AryanRai/mech5720-2026-event-scanner/report/figures/nd_APS_pair.pdf

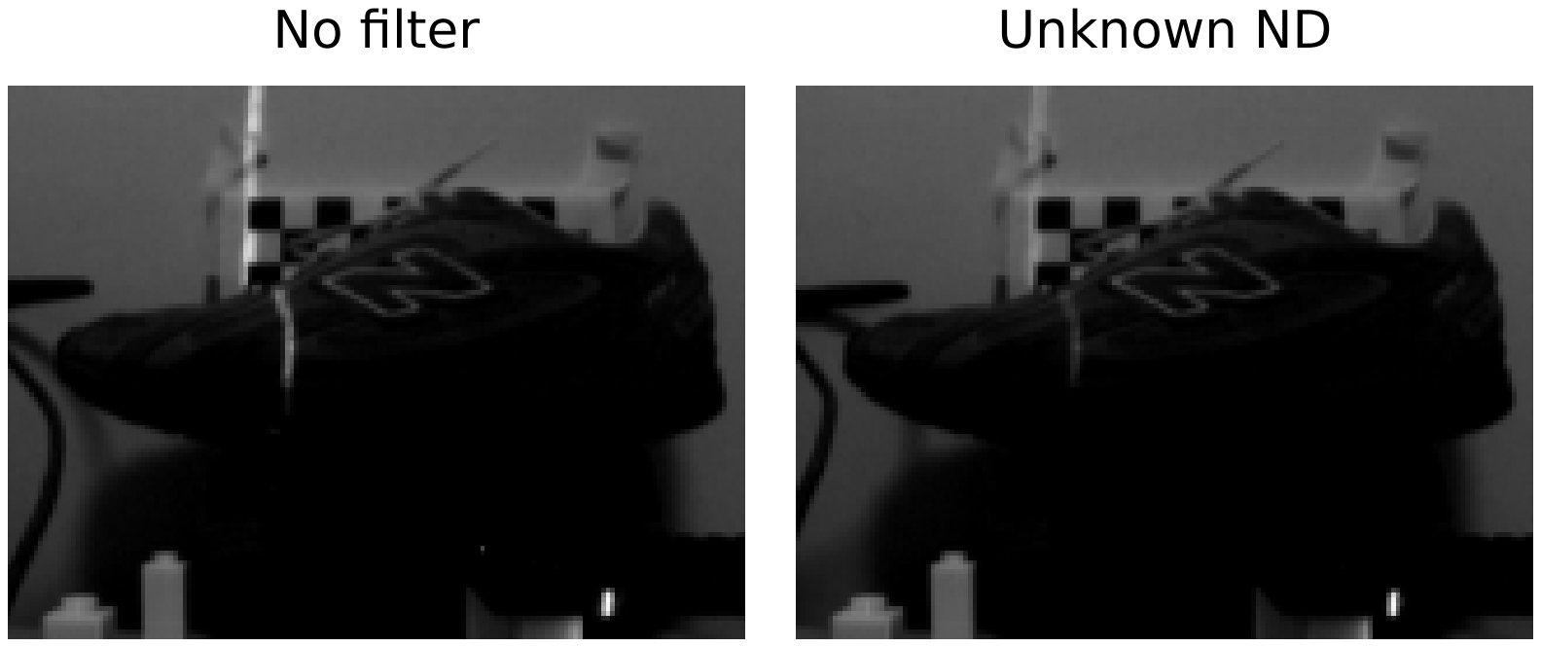
[picture p32: page 1]

No filter | Unknown ND
