AryanRai/mech5720-2026-event-scanner/report/figures/triangulation_compact.pdf

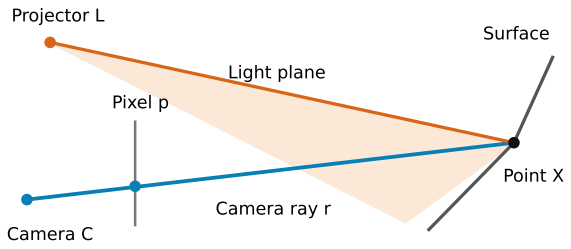
[picture p33: figure]
Camera C; Projector L; Pixel p; Camera ray r; Light plane; Point X; Surface
