AryanRai/mech5720-2026-event-scanner/output/pdf/checkerboard_9x6_A4.pdf

9 x 6 inner corners | 10 x 7 squares | square size: 18 mm
Print on A4 at 100% / actual size. Measure a square after printing.
