AryanRai/mech5720-2026-event-scanner/docs/images/aps_cloud.png

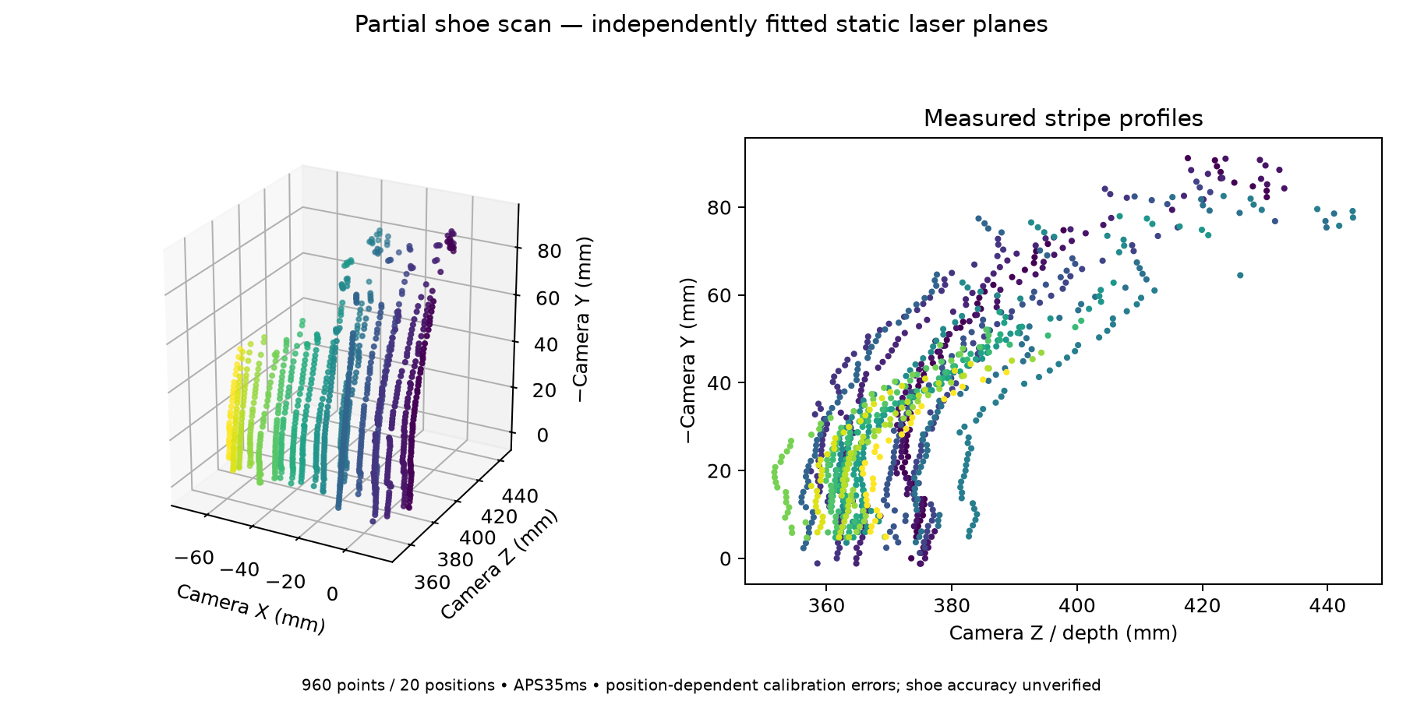
docs/images/aps_cloud.png
