AryanRai/mech5720-2026-event-scanner/examples/coverage/repro_data/shoe_photo.png

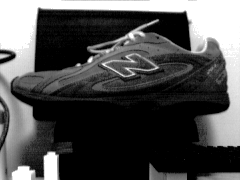
examples/coverage/repro_data/shoe_photo.png
