AryanRai/mech5720-2026-event-scanner/outputs/analysis/hardware_sanity_02/diagnostics.png

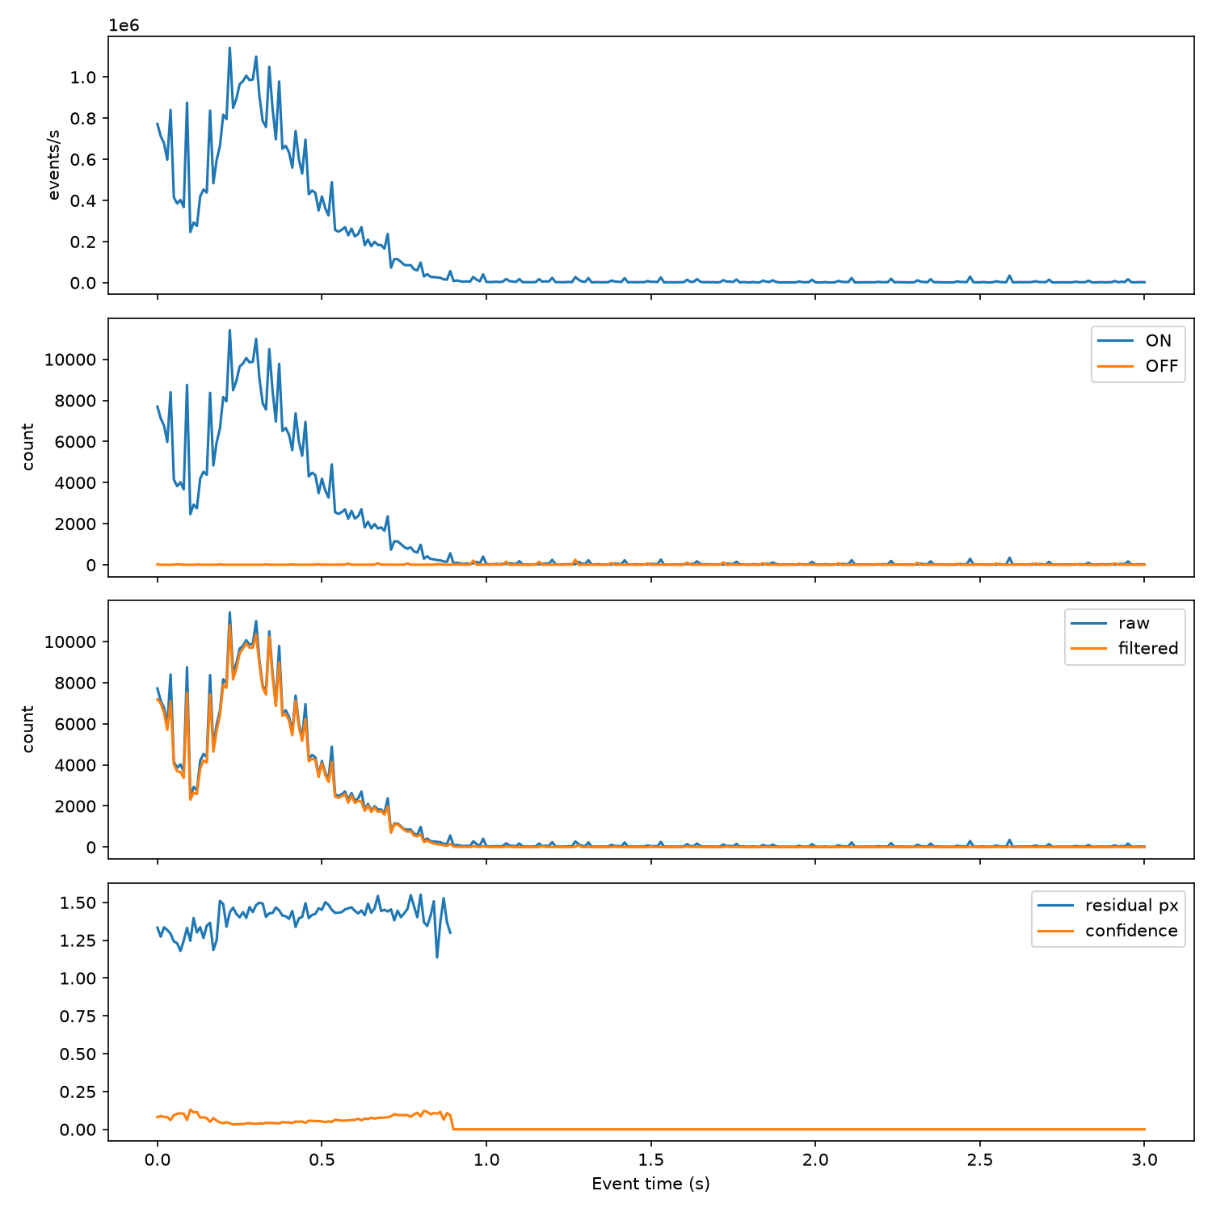
outputs/analysis/hardware_sanity_02/diagnostics.png
