AryanRai/mech5720-2026-event-scanner/outputs/current_aps.png

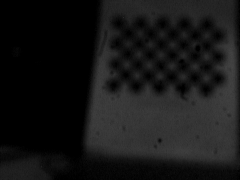
outputs/current_aps.png
