AryanRai/mech5720-2026-event-scanner/outputs/lens_diagnostic/exposure_80ms.png

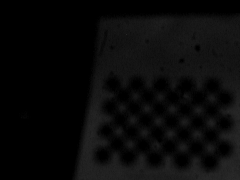
outputs/lens_diagnostic/exposure_80ms.png
