AryanRai/mech5720-2026-event-scanner/report/figures/board_comparison.png

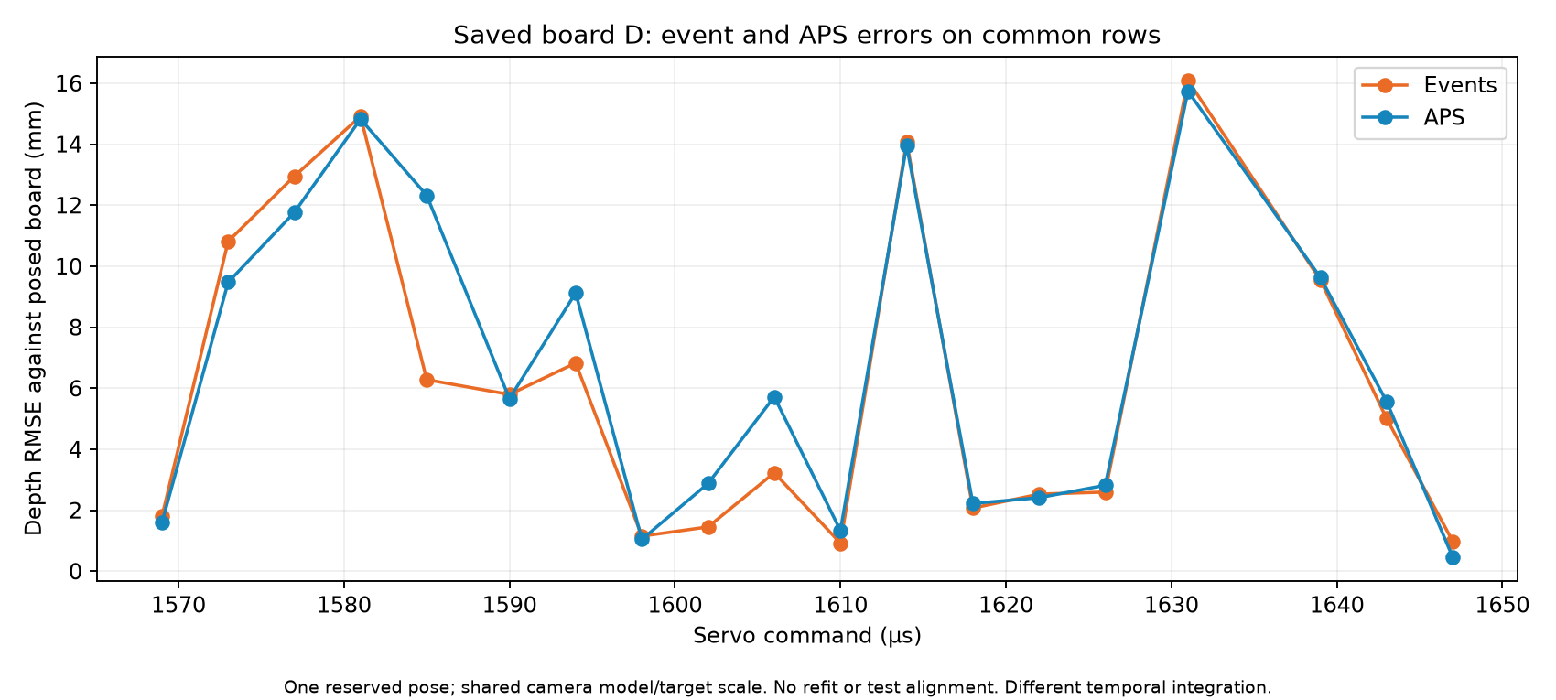
report/figures/board_comparison.png
