AryanRai/mech5720-2026-event-scanner/report/figures/dashboard.jpg

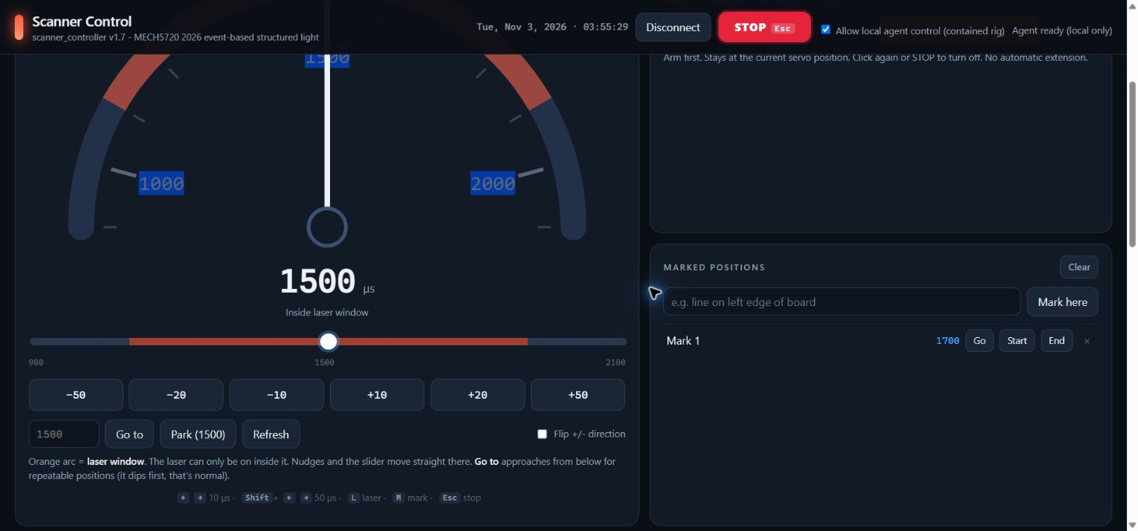
report/figures/dashboard.jpg
