AryanRai/mech5720-2026-event-scanner/report/figures/intrinsic_refinement.png

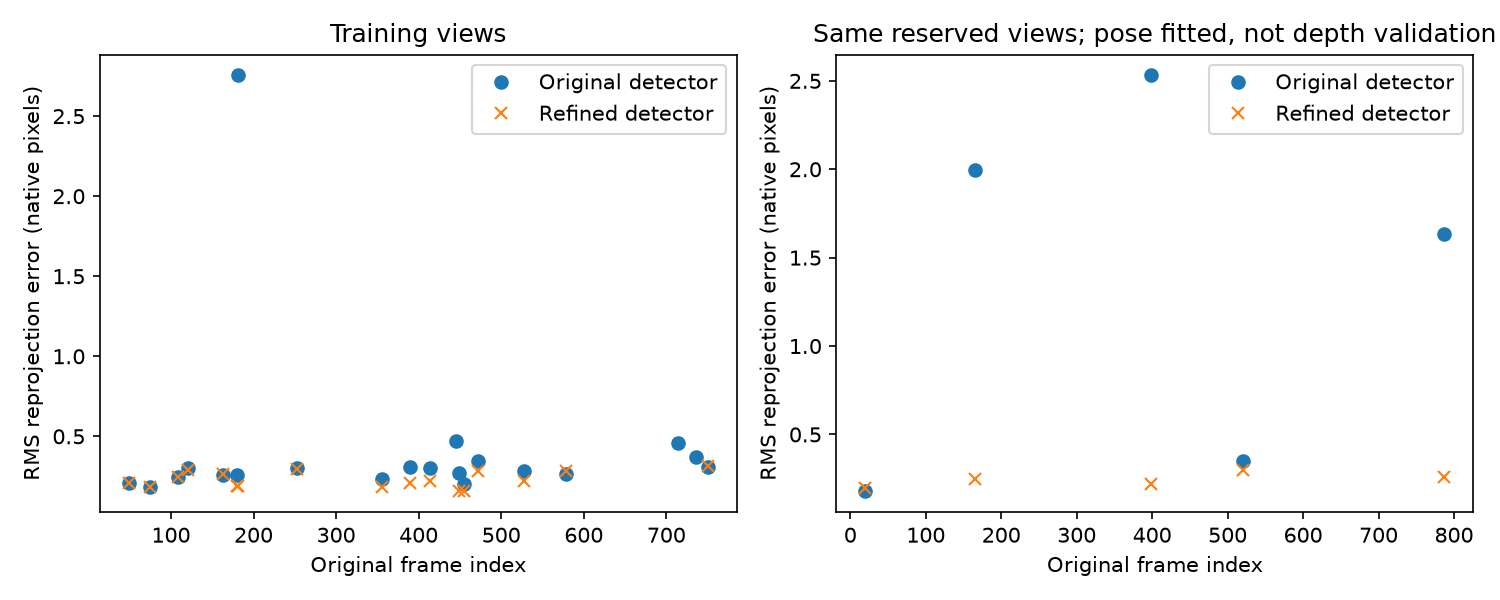
report/figures/intrinsic_refinement.png
