AryanRai/mech5720-2026-event-scanner/report/figures/nd_comparison.png

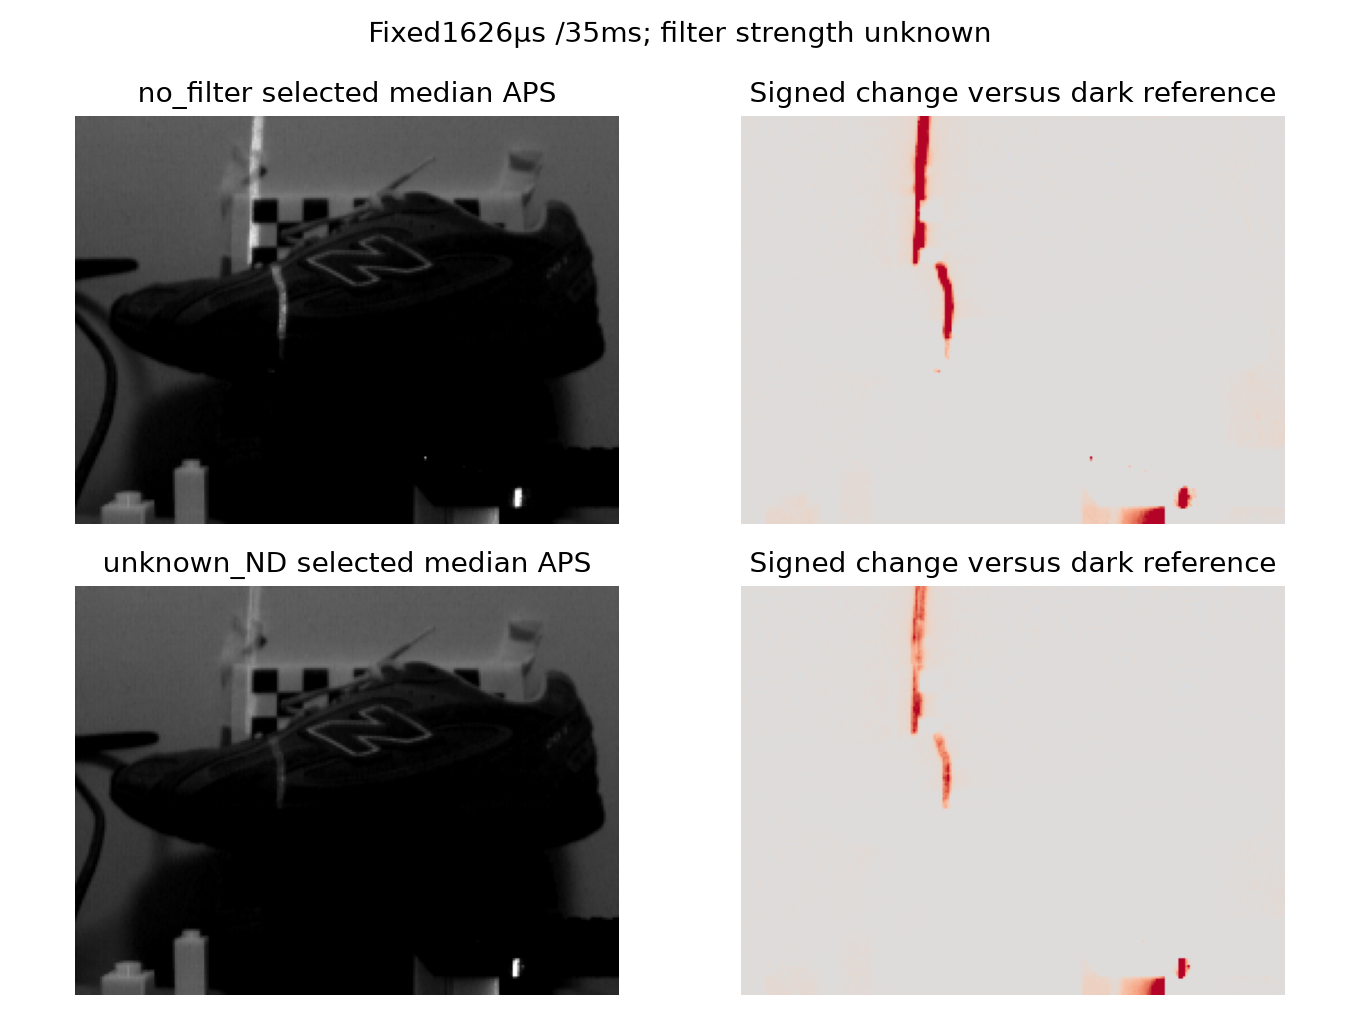
report/figures/nd_comparison.png
