AryanRai/mech5720-2026-event-scanner/report/figures/real_stripe_photo.jpg

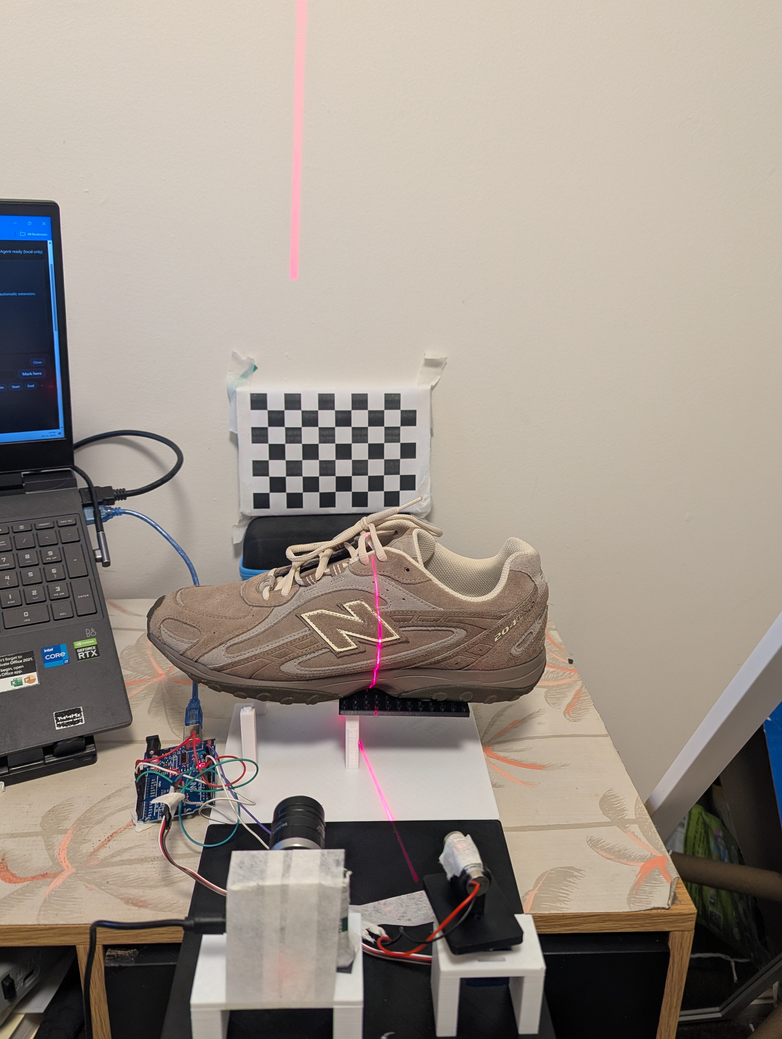
report/figures/real_stripe_photo.jpg
