AryanRai/mech5720-2026-event-scanner/report/figures/repeatability.png

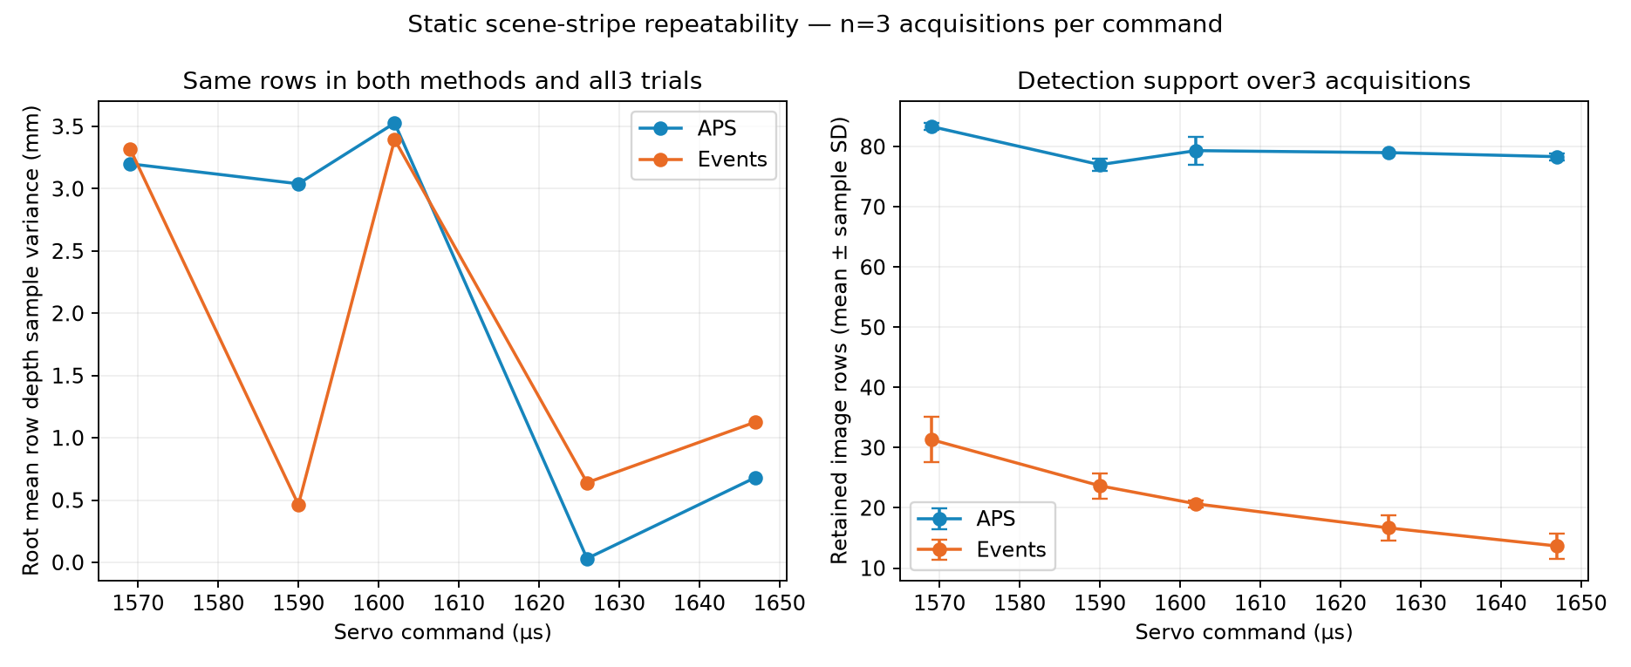
report/figures/repeatability.png
