AryanRai/mech5720-2026-event-scanner/report/figures/timing.png

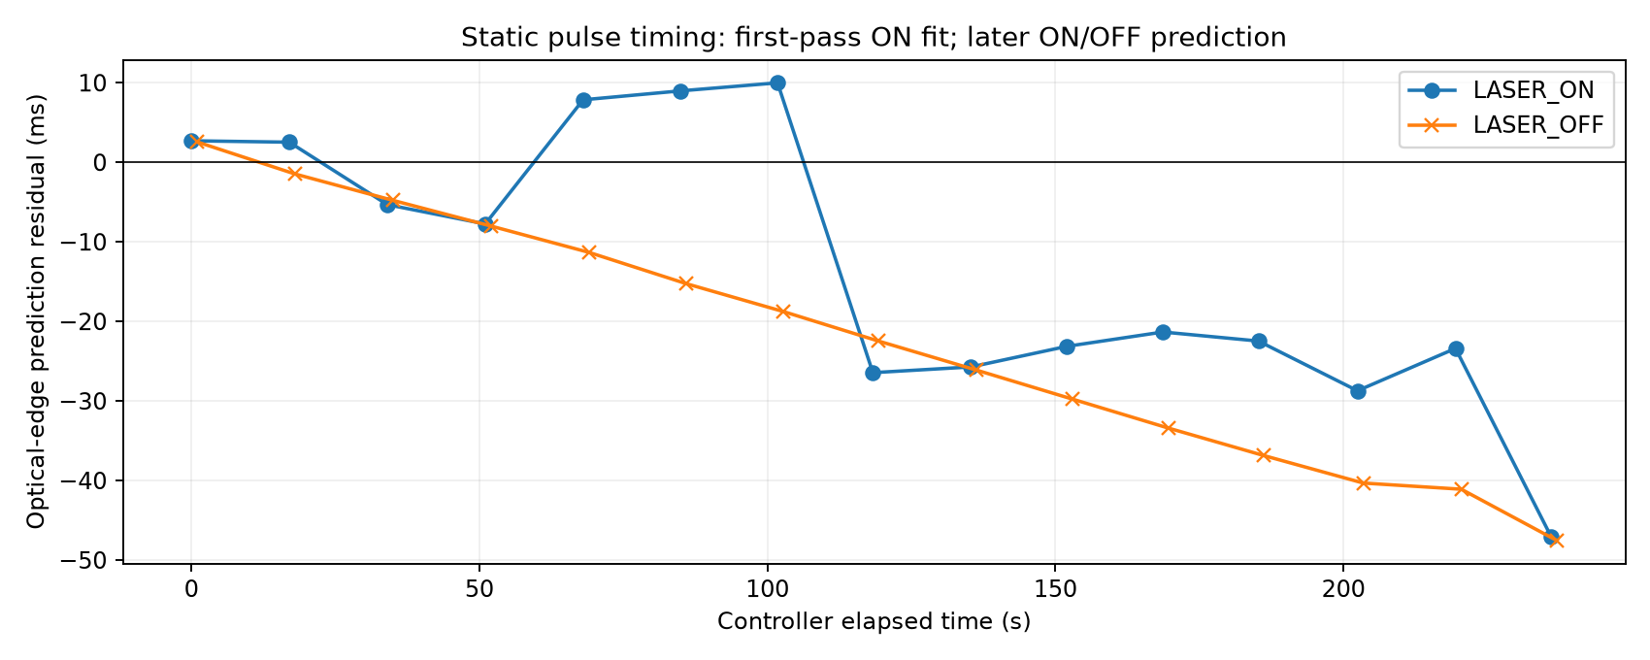
report/figures/timing.png
