AryanRai/mech5720-2026-event-scanner/report/figures/triangulation_schematic.png

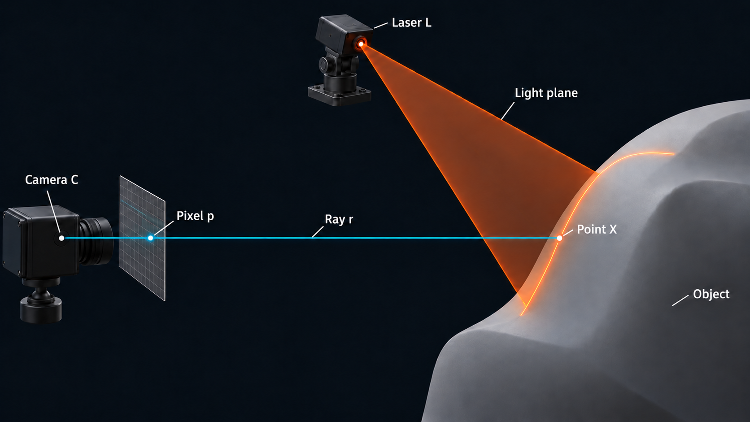
report/figures/triangulation_schematic.png
