AryanRai/mech5720-2026-event-scanner/hardware/cad_review/DAVIS240C_Scanner_Review.step

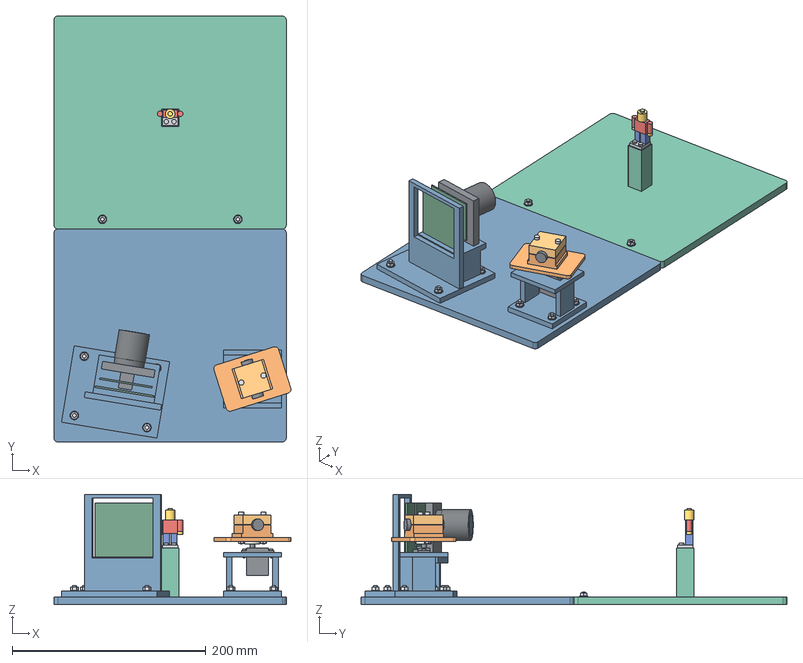
[picture p48: CAD file, 2026-11-07]
hardware/cad_review/DAVIS240C_Scanner_Review.step
244.9 x 440.0 x 114.0 mm
01_Solid_Base
02_DAVIS_Upright_Bracket
03_Servo_Bracket
REF_Servo_Provisional
REF_Servo_Horn_Provisional
04_Rotating_Laser_Cradle
05_Laser_Clamp_Lower
06_Laser_Clamp_Upper
REF_Laser_Provisional
REF_Laser_Aperture
REF_DAVIS240C_Housing_Simplified
REF_DAVIS240C_Boards_Simplified
REF_Lens_Envelope_TBC
REF_Lens_Front_Glass
07_Object_Base_With_Studded_Pedestal
REF_Real_LEGO_Plate_Approximate
REF_Minifigure_Legs_Approximate
REF_Minifigure_Torso_Approximate
REF_Minifigure_Head_Hands_Approximate
REF_Base_Fixing_01
REF_Base_Fixing_02
REF_Base_Fixing_03
REF_Base_Fixing_04
REF_Base_Fixing_05
REF_Base_Fixing_06
REF_Base_Fixing_07
REF_Base_Fixing_08
REF_Camera_Quarter_Inch_Screw_TBC
REF_Joining_M4_Fixing_1
REF_Joining_M4_Fixing_2
REF_Servo_Ear_Screw_01_TBC
REF_Servo_Ear_Screw_02_TBC
REF_Clamp_M3_Fixing_01
REF_Clamp_M3_Fixing_02
REF_Horn_to_Cradle_Screw_01_TBC
REF_Horn_to_Cradle_Screw_02_TBC
REF_Horn_Centre_Screw_TBC
