AryanRai/mech5720-2026-event-scanner/report/figures/scanner_wiring.png

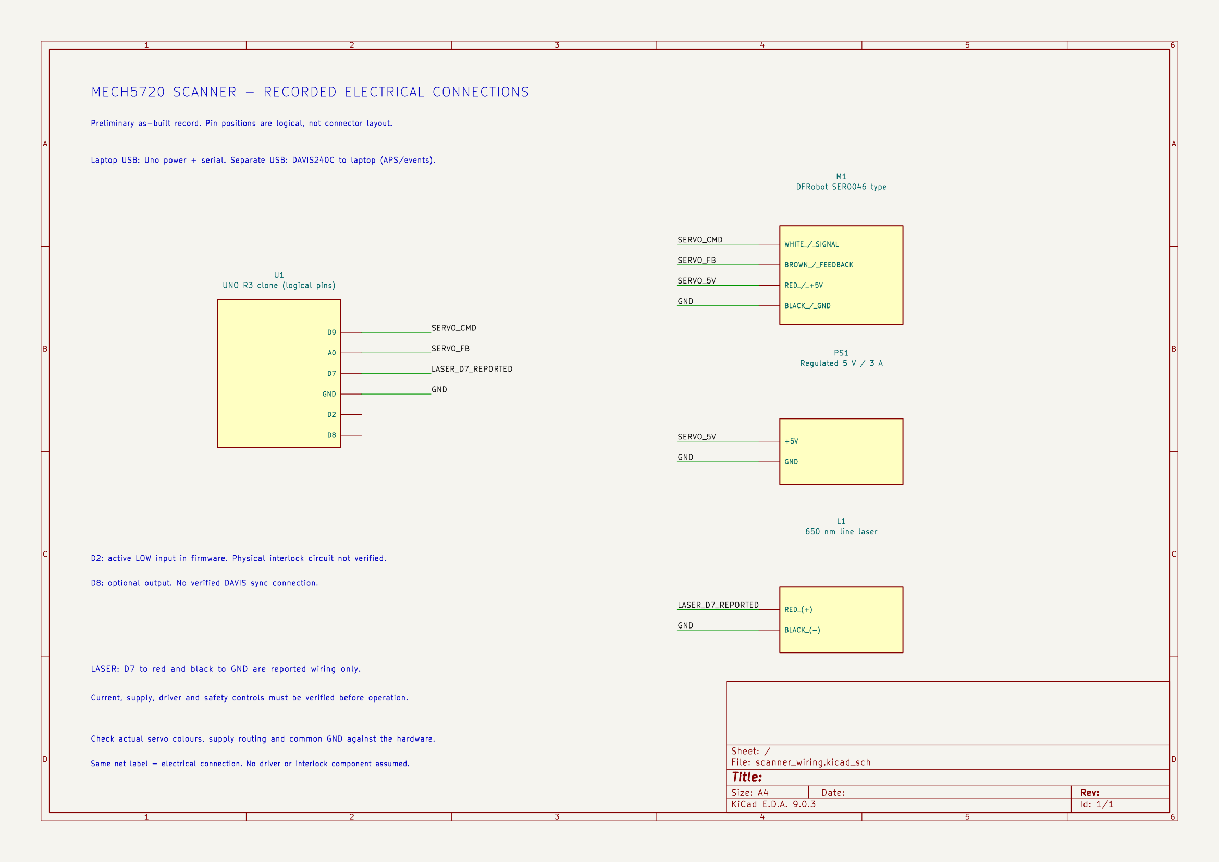
report/figures/scanner_wiring.png
