AryanRai/mech5720-2026-event-scanner/results/platform_audit/REVIEW.md

# Earlier four-hole-mount platform audit — 8 November 2026

User identifies these earlier captures as the original four-hole mounting, before the subsequent leftward remount. This audit uses the older recordings and their original frozen ABDE2 calibration, not the later dense ABC fit. No hardware operation or new capture occurred.

Examined original sparse scan: five retained source recordings at 1569, 1602, 1618, 1634 and 1651 us (the original 1520 observation had no retained valid source observation in the reconstruction manifest and is not silently counted). Original denser preview: four independently fitted calibration knots, excluding interpolated-plane commands. Also examined the early 20-position independently fitted scan. All raw paths/hashes and frame selections are in the respective summary.json files.

The original sparse scan yields 102 lower-row image-change candidates (23/20/19/27/13 at the five commands), including more coherent vertical segments below the shoe. The original denser preview's four fitted knots yield 84; the early calibrated twenty-position dataset yields 140. These are post-hoc lower-image candidates, not confirmed platform detections or coverage numerators. Bright spots/supports may also qualify. No hand-labelled stripe ground truth was created. The original shoe reconstruction was not modified.

The illustrated lower-image region is rows 120..179, extending the prior row-group screen with delta>20 and intensity>40, maximum width12, ambiguity rejection, clipping rejection and repeated-frame support. Optical peaks are searched within 2..6 seconds and the connected half-peak interval is retained. Candidate coordinates and unvalidated ray/plane intersections are saved separately. Camera timestamp selection is not physical synchronisation. Earlier sparse frames use different exposure from later captures; this is not a controlled density comparison.

Four-hole mounting removes the specific leftward-remount ambiguity for this condition, but does not independently measure the camera-to-CAD transform. Current CAD contains nominal component envelopes, provisional interfaces and an approximate LEGO plate. Actual optical pose changed during the project. A complete metric reference face requires identified CAD-to-image feature correspondences and a justified pose, visible boundaries and tolerance. Fitting those to the same recovered platform points and measuring their residuals would be self-consistency, not independent completeness/accuracy.

Conclusion: older data has more useful candidate platform traces than the latest five-line demonstration. It is the correct historical condition to investigate, but an independently anchored expected metric surface is still missing. Do not mark physical completeness complete or report a percentage from these candidate counts. The published image-space shoe coverage is unchanged. A clearly identifiable retained setup image/measurement establishing the actual mounted face and pose could permit further analysis without another scan; nominal assembly placement alone is insufficient.

Figure: platform_audit.png; numerical candidates: lower_candidates.csv; raw hashes/frame selections/model hash: summary.json. The script can be rerun with --dataset original_sparse / original_dense / early_calibrated and a new --output directory. Initial version01 contact sheets contained unused axes; version02 fixes only the displayed command layout. The candidate values are unchanged.

The report now records the 102 candidates as an exploratory reuse audit, explicitly not a physical-completeness result. Newer wiring illustrations/photographs present in the live Overleaf source were preserved; their repository image copies were extracted from the downloaded compiled PDF, not independently obtained or newly measured. The full schematic remains in report/figures/scanner_wiring.png.
