AryanRai/mech5720-2026-event-scanner/results/platform_audit/lower_candidates.csv

command_us | pixel_x | pixel_y | support_frames | X_mm | Y_mm | Z_mm | positive_finite_depth
1569 | 221.2140350877193 | 124.0 | 21.0 | 55.231525802844445 | 10.404348803886734 | 156.37146965776742 | True
1569 | 221.0 | 125.0 | 21.0 | 55.17555708489025 | 10.939747271831346 | 156.53621707822396 | True
1569 | 220.65758754863813 | 127.0 | 21.0 | 55.080500902963024 | 12.007607750725926 | 156.77934835752401 | True
1569 | 220.36206896551724 | 128.0 | 21.0 | 55.00833342058555 | 12.552234248978744 | 157.02548506498 | True
1569 | 220.0 | 129.0 | 21.0 | 54.922776214906065 | 13.103809357394788 | 157.33905436974553 | True
1569 | 219.79918032786884 | 130.0 | 21.0 | 54.86924993342831 | 13.644138207214219 | 157.4900677574152 | True
1569 | 219.29655172413794 | 131.0 | 21.0 | 54.75512828580319 | 14.211558019529866 | 157.9472555601582 | True
1569 | 219.0 | 132.0 | 20.0 | 54.6821182933906 | 14.763586149192491 | 158.1960244077463 | True
1569 | 218.0 | 133.0 | 21.0 | 54.465915743346514 | 15.383285389715333 | 159.16746738921142 | True
1569 | 217.0 | 134.0 | 21.0 | 54.247352450474395 | 16.01021807291764 | 160.14940969231918 | True
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
