AryanRai/mech5720-2026-event-scanner/data/calibration/intrinsics/images/image_20261030_163826_587536.png

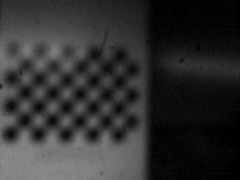
data/calibration/intrinsics/images/image_20261030_163826_587536.png
