AryanRai/mech5720-2026-event-scanner/data/calibration/intrinsics/images/image_20261030_164251_771076.png

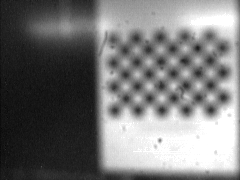
data/calibration/intrinsics/images/image_20261030_164251_771076.png
