AryanRai/mech5720-2026-event-scanner/data/calibration/intrinsics/images/image_20261030_165030_823524.png

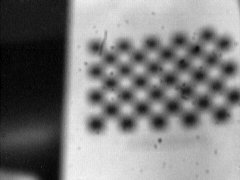
data/calibration/intrinsics/images/image_20261030_165030_823524.png
