AryanRai/mech5720-2026-event-scanner/outputs/calibration_inspect.png

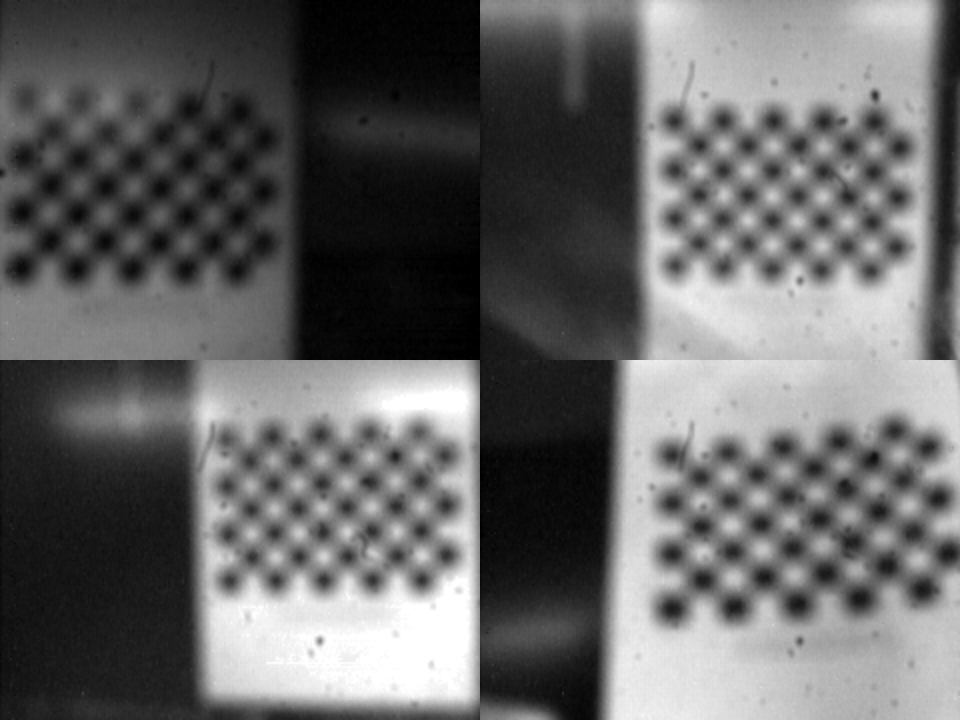
outputs/calibration_inspect.png
