AryanRai/mech5720-2026-event-scanner/results/platform_audit/platform_audit.png

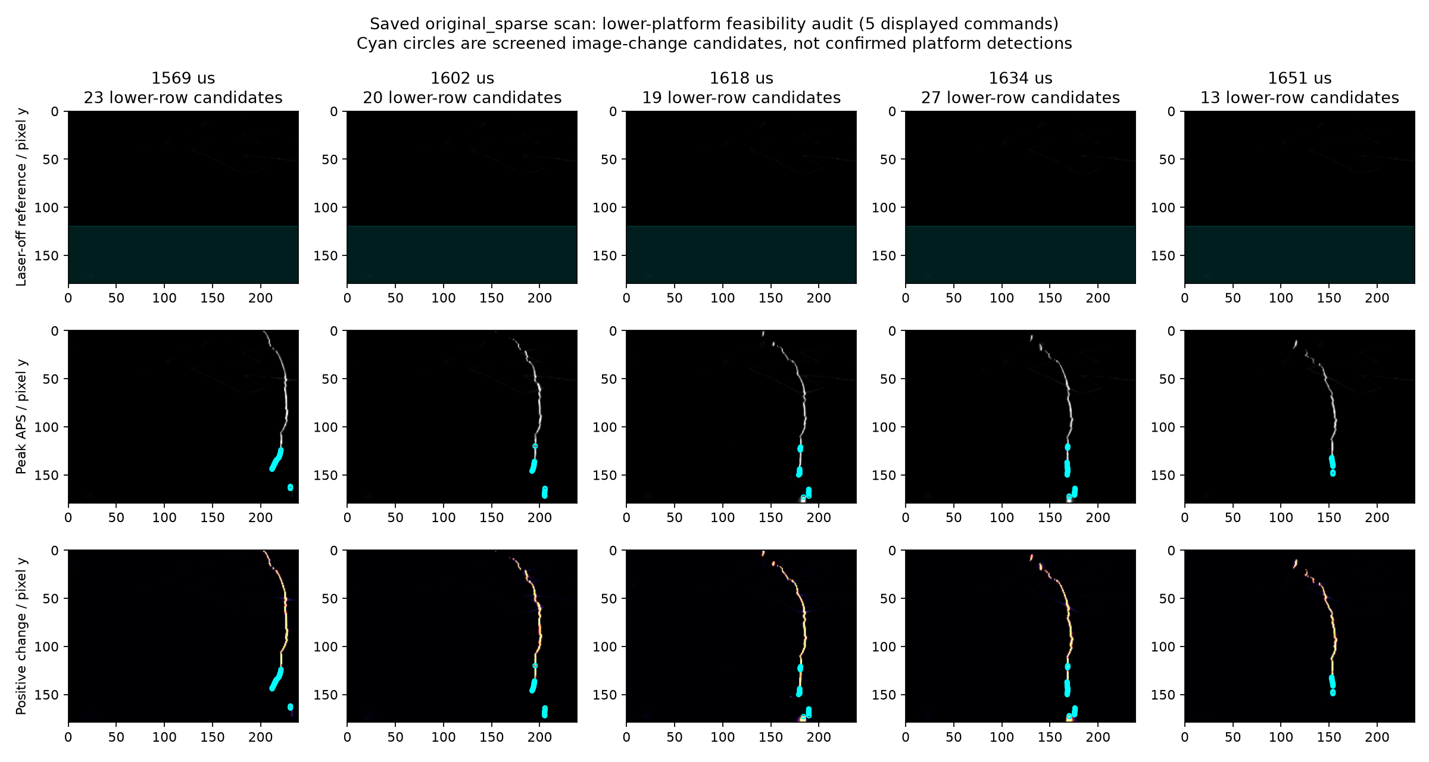
results/platform_audit/platform_audit.png
