AryanRai/mech5720-2026-event-scanner/report/figures/intrinsic_refinement_compact.pdf

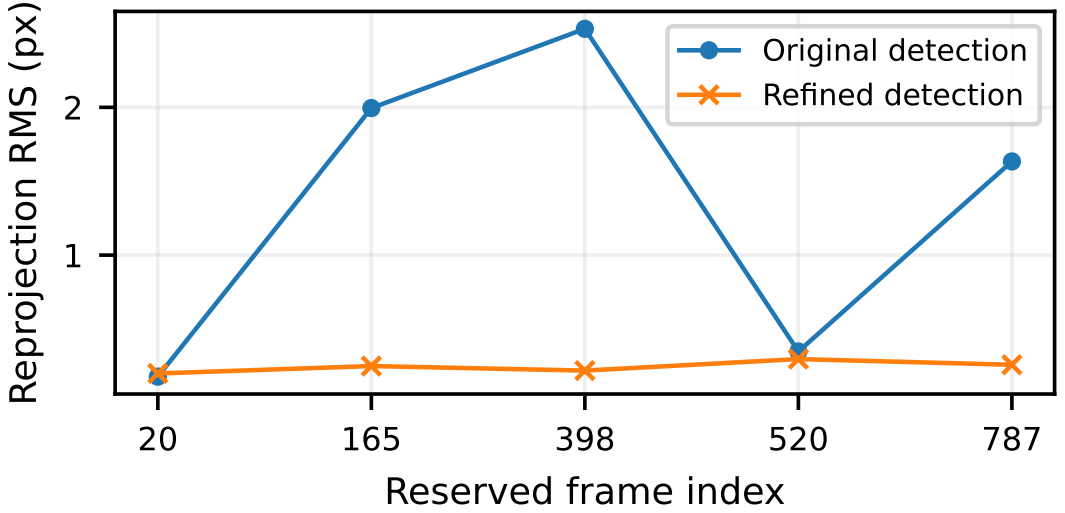
[picture p56: page 1]
Original detection Re; fined detection

Reprojection RMS (px)

Reserved frame index
