AryanRai/mech5720-2026-event-scanner/report/figures/board_compact.pdf

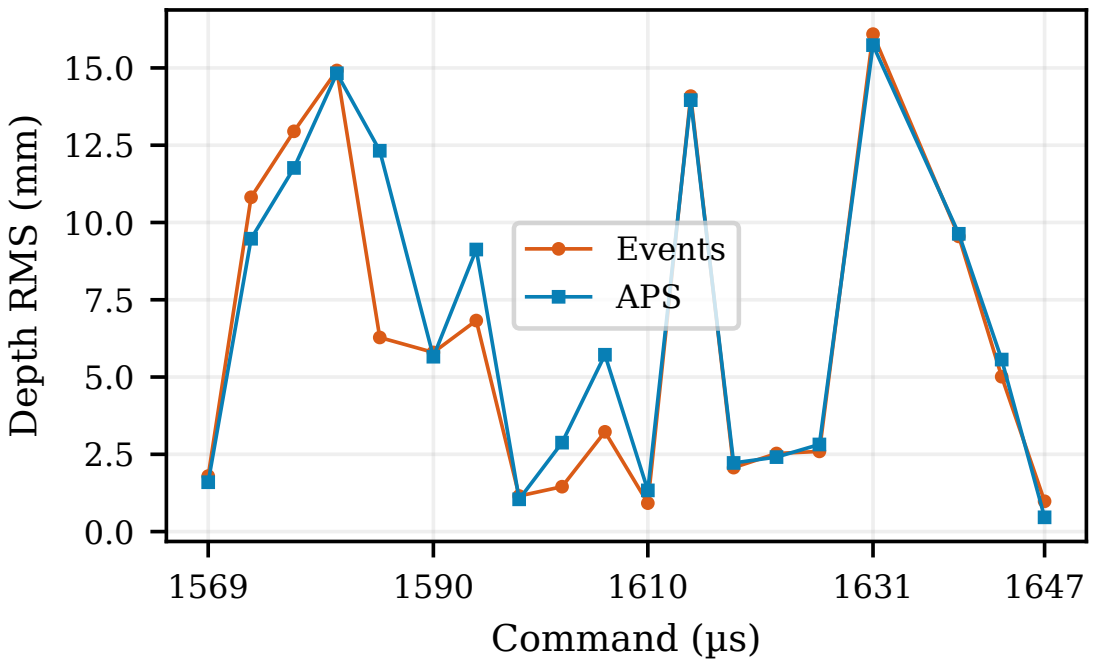
[picture p57: page 1]
Command (µs); Events APS

Depth RMS (mm)
