AryanRai/mech5720-2026-event-scanner/report/figures/coverage_compact.pdf

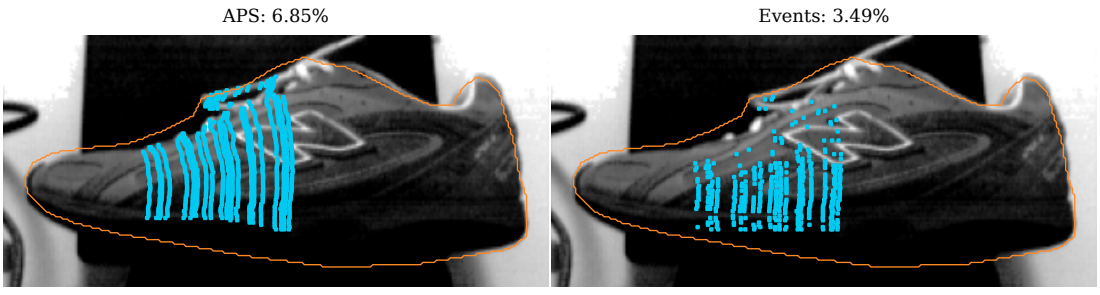
[picture p58: page 1]
APS: 6.85%; Events: 3.49%
