AryanRai/mech5720-2026-event-scanner/report/figures/paired_clouds.pdf

## APS: 960 points

## Static events: 494 points

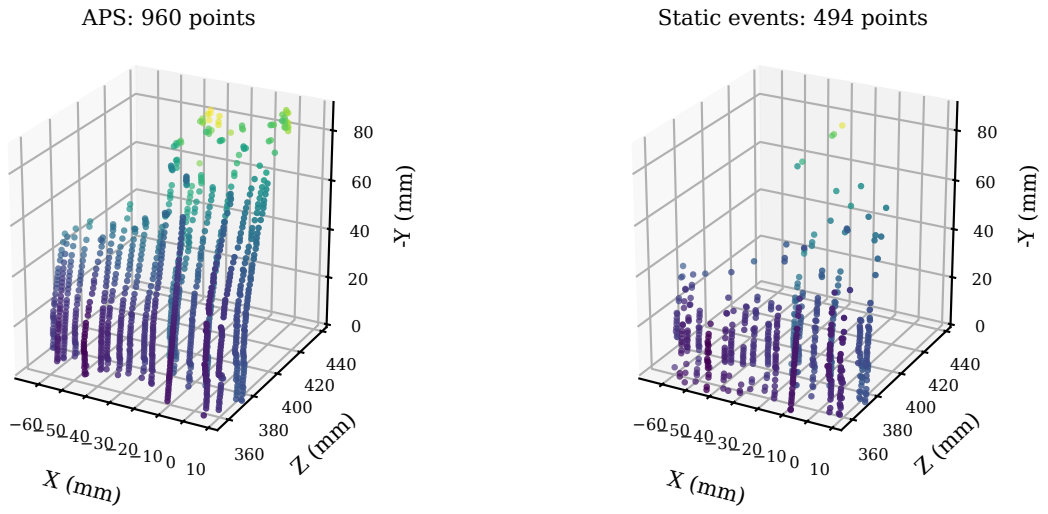
[picture p59: page 1]
