AryanRai/mech5720-2026-event-scanner/report/figures/repeat_compact.pdf

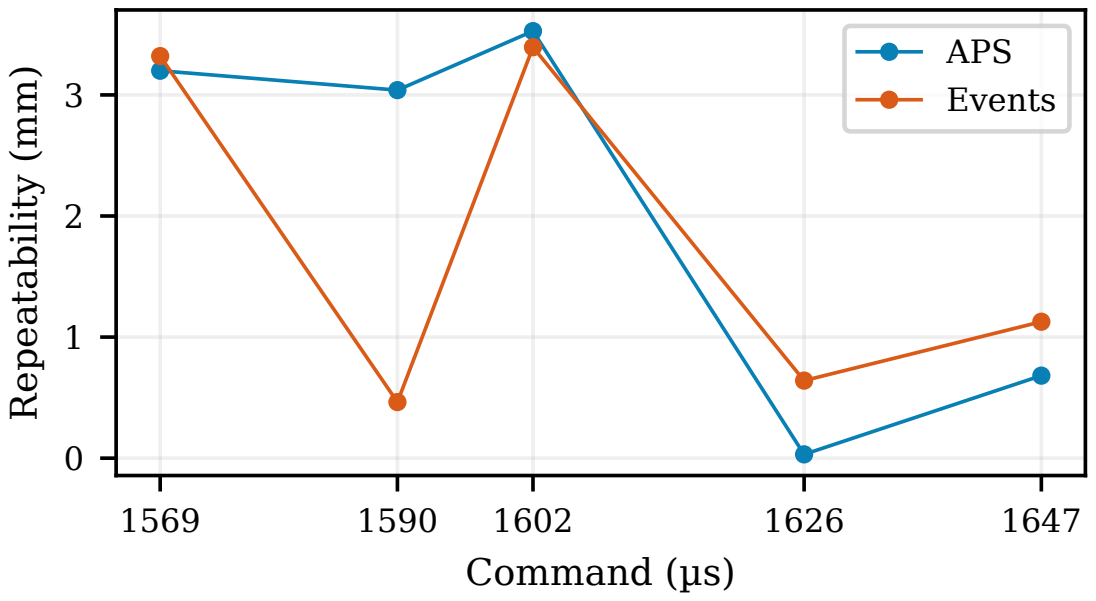
[picture p60: page 1]
Command (µs); Repeatability (mm); APS Events
