AryanRai/mech5720-2026-event-scanner/report/figures/timing_compact.pdf

−50 −40 −30 −20 −100

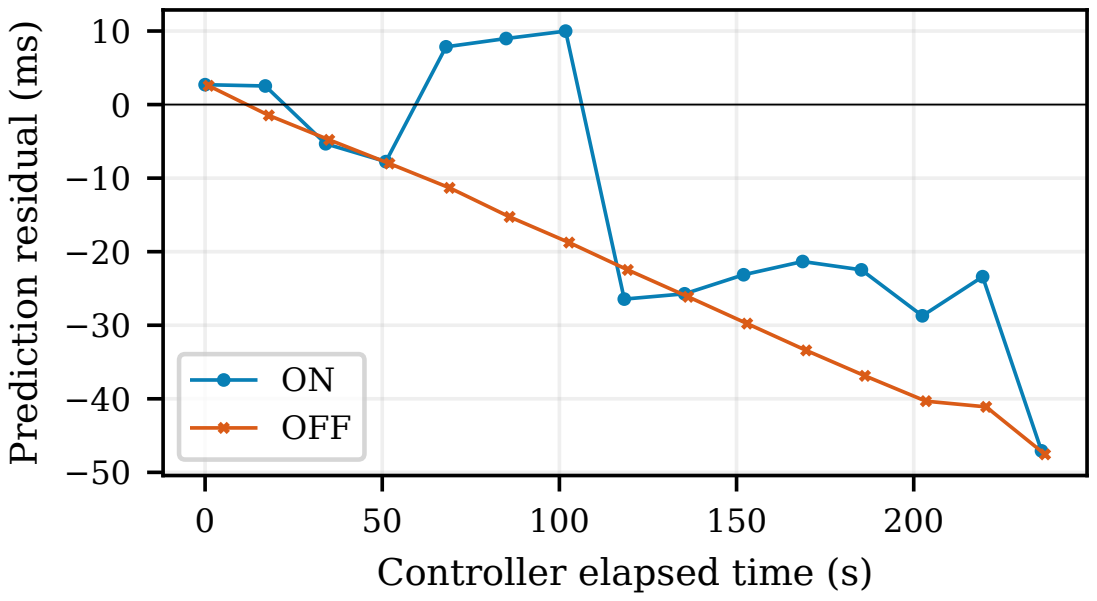
[picture p61: page 1]

Prediction residual (ms)

ON
OFF

Controller elapsed time (s)
