AryanRai/mech5720-2026-event-scanner/(commit log)

2026-11-07 Publish reviewed MECH5720 scanner code, build guide and retained evidence
    [DAVIS240C_Scanner_Review.step, aps_points.csv, captures.csv, event_points.csv]
2026-11-07 Retain original tracked sample recordings and diagnostic fixtures
    [windows.csv]
2026-11-08 Report exploratory platform results from the original scan
    [lower_candidates.csv]
